Clo-udhye/WIZNETIAN-IoT-Contest/Wiznetian_IoT_Design_Contest_우수상.jpg

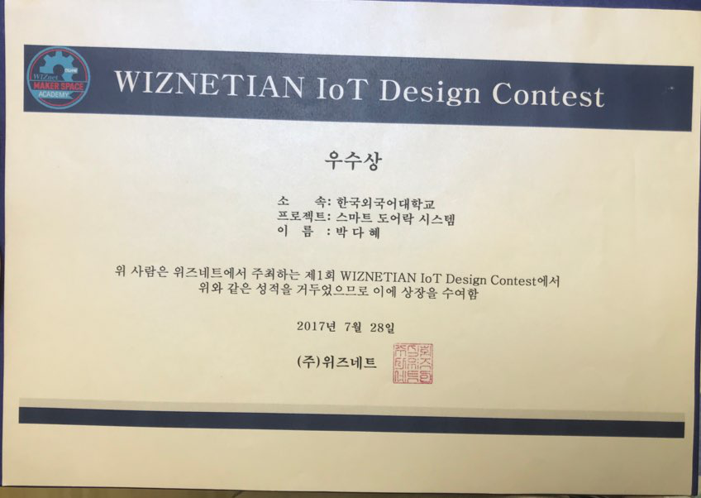
Wiznetian_IoT_Design_Contest_우수상.jpg
