Clo-udhye/WIZNETIAN-IoT-Contest/공모전 포스터.jpg

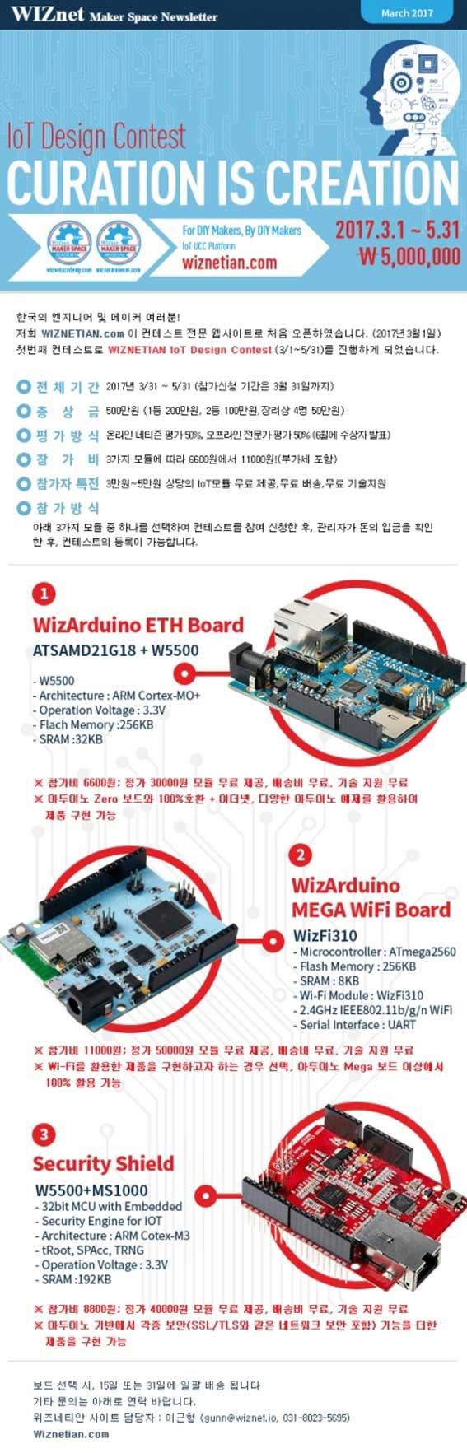
공모전 포스터.jpg
